DSHardman/RingActuator/Figures/BareActuator.jpeg

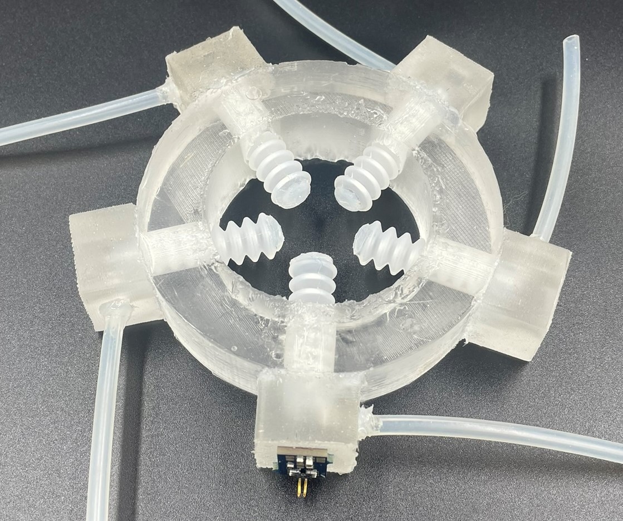
Figures/BareActuator.jpeg
