DSHardman/RingActuator/GeometryPlots.docx

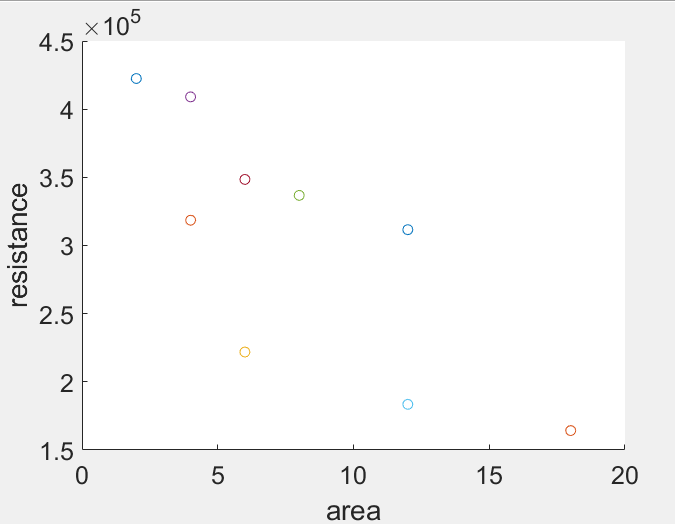
[picture p12: figure]
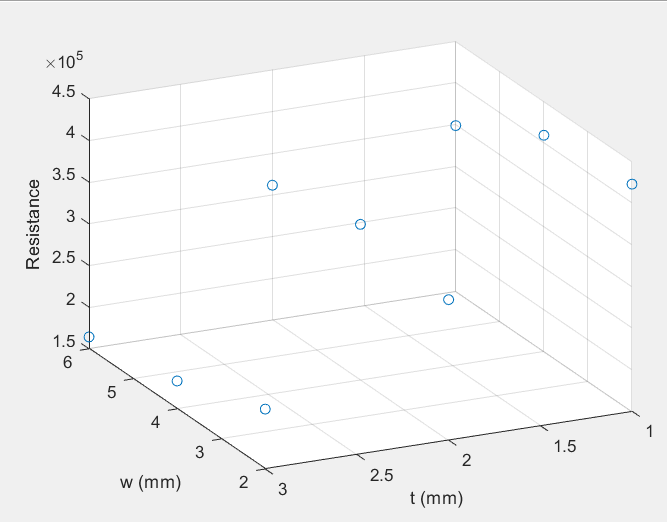
[picture p13: figure]
