DSHardman/RingActuator/Figures/Sensitivities.pdf

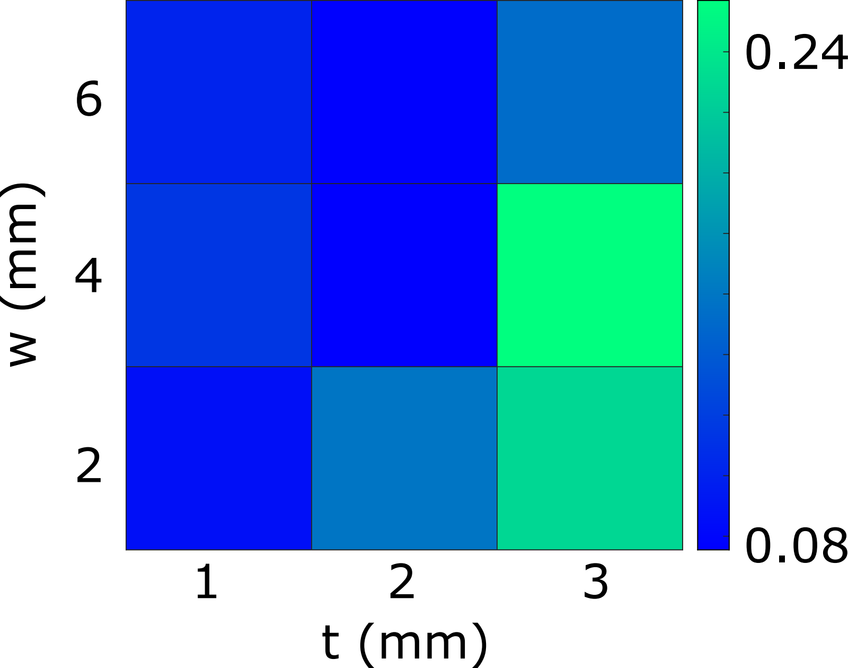
[picture p14: page 1]

1 2

246

t (mm)

w (mm)

3

0.08

0.24
