DSHardman/RingActuator/Figures/SingleFinger3.pdf

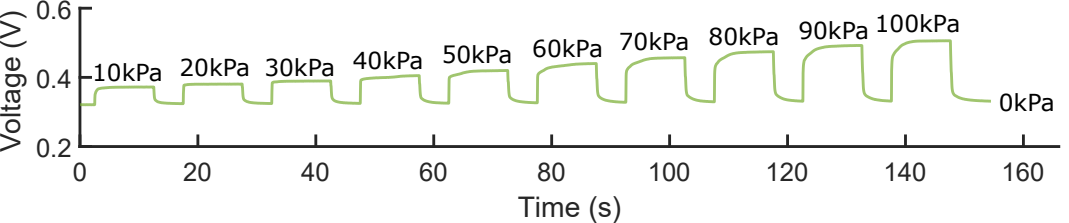
[picture p15: page 1]
Time (s); Voltage (V); 10kPa 20kPa 30kPa 40kPa 50kPa 60kPa 70kPa 80kPa 90kPa 100kPa; 0kPa
