DSHardman/RingActuator/Figures/ClosedLoop.pdf

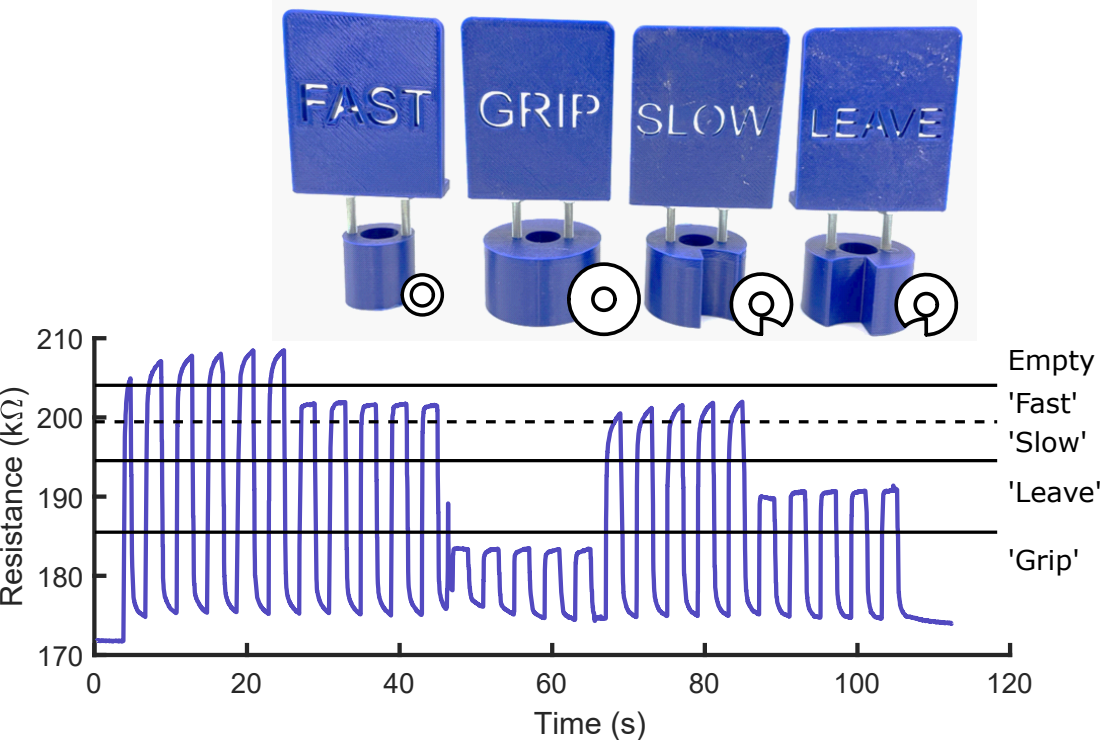
[picture p16: page 1]
Time (s); Resistance (k ); Empty 'Fast'; 'Grip'; 'Slow'; 'Leave'
