DSHardman/RingActuator/Figures/RotateResponse.pdf

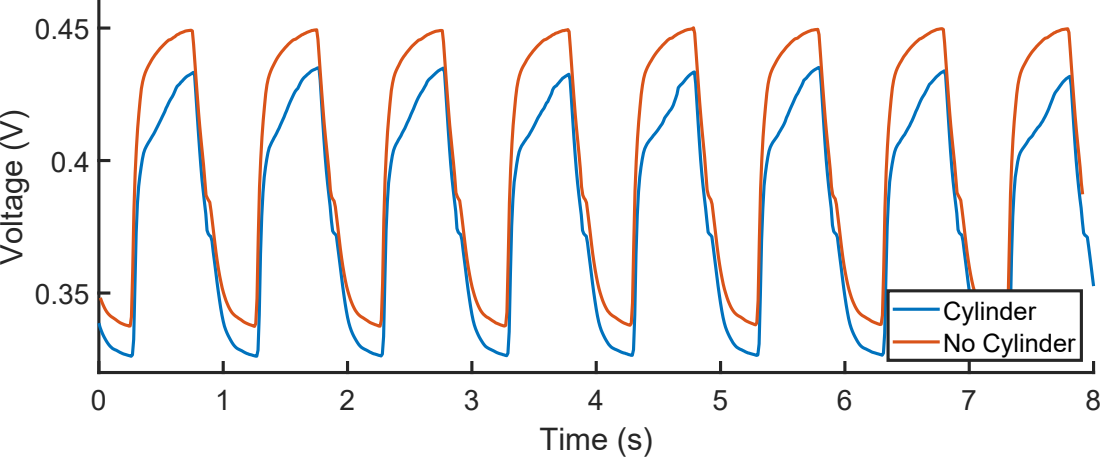
[picture p17: page 1]
Time (s); Voltage (V); Cylinder No Cylinder
