DSHardman/RingActuator/Figures/Healing.pdf

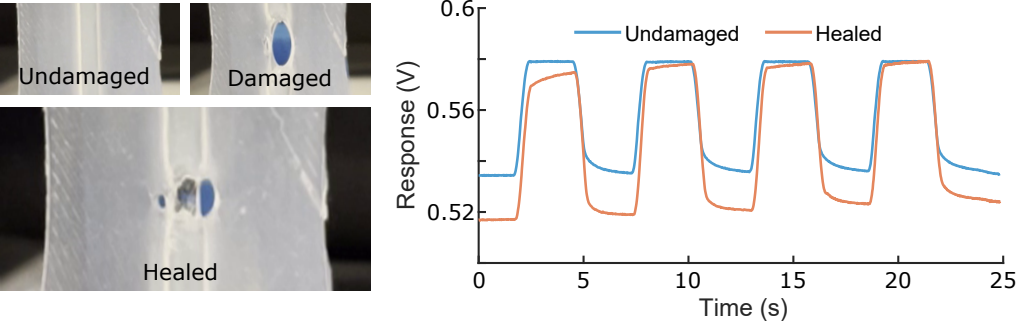
[picture p18: page 1]
Undamaged; Healed; Response (V); Time (s); Damaged
