DSHardman/RingActuator/(commit log)

2022-02-04 proof of concept actuator testing
2022-02-23 actuator figures
2022-02-23 convert actuator results to subfigures
